JPH-Botron/WiegandEmulator/WiegandTestHolder.FCStd

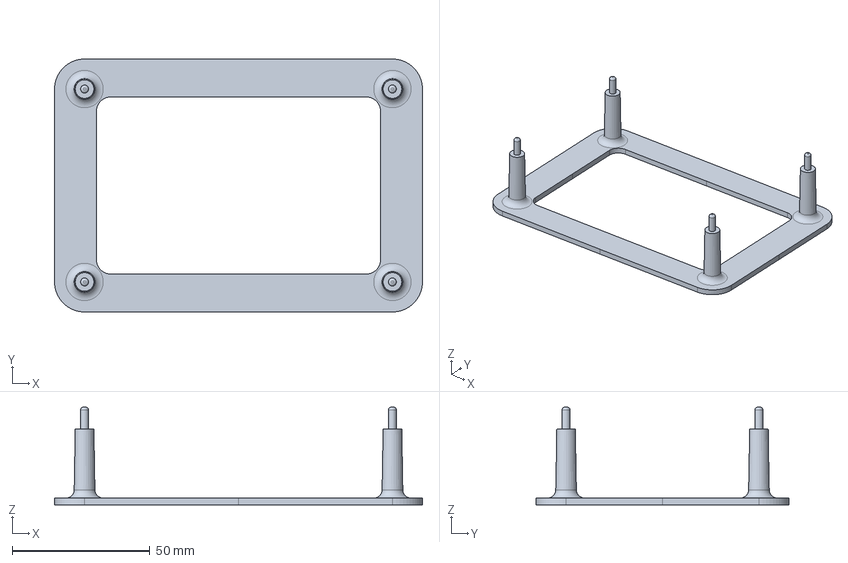
[picture p1: CAD file, 2025-12-03]
WiegandTestHolder.FCStd
133.6 x 91.8 x 35.5 mm
