JPH-Botron/WiegandEmulator/WiegandTest.step

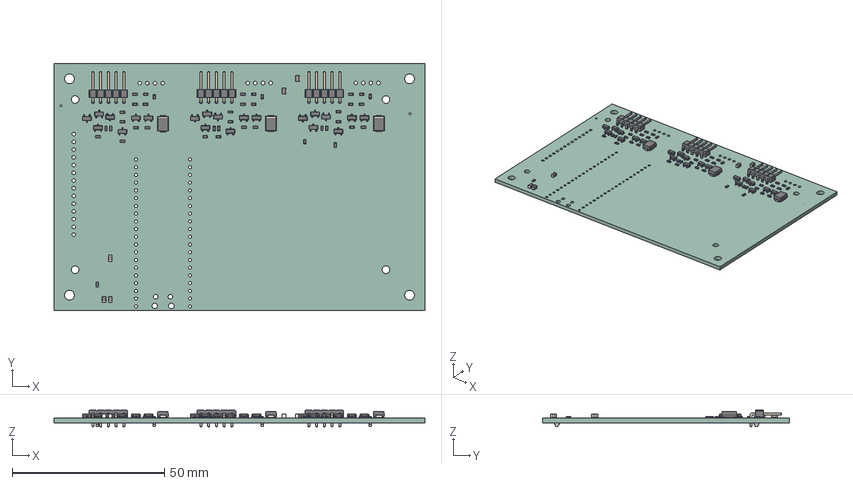
[picture p2: CAD file, 2025-12-03]
WiegandTest.step
121.9 x 81.3 x 5.54 mm
SOT_23 x 21
R_0603_1608Metric x 40
C_0805_2012Metric x 5
PinHeader_1x05_P254mm_Horizontal x 3
D_SMB x 3
LED_0603_1608Metric x 4
WiegandTest_PCB
