JPH-Botron/WiegandEmulator/3D/1881464_00.stp

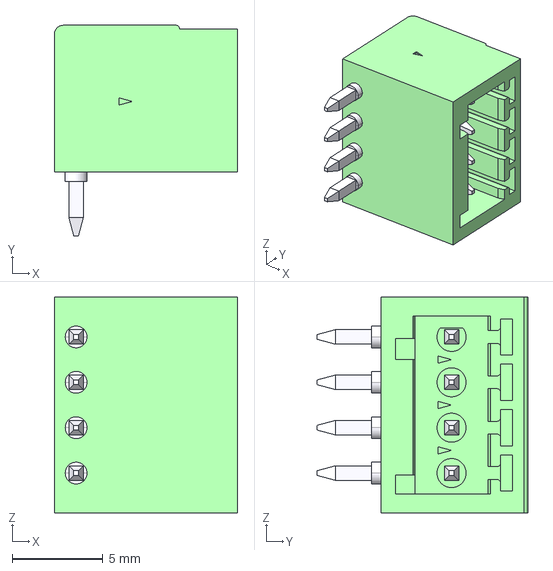
[picture p3: CAD file, 2025-11-04]
3D/1881464_00.stp
10.1 x 11.6 x 11.9 mm
