JPH-Botron/WiegandEmulator/(list of files, cad)

Other CAD files:
WiegandTestHolder-Body.step
