JPH-Botron/WiegandEmulator/(commit log)

2025-11-04 Initial Revision
    [1881464_00.stp, CPU.kiicad_sch.kicad_sch, Channels.kicad_sch, Interface.kicad_sch, WiegandTest.kicad_pcb, WiegandTest.kicad_sch]
2025-11-04 Mostly done. Still need to do connections to LCD; waiting to get an actual LCD to verify connector location on PCB part. May need to switch to 14 pin FFC, but hopefully not.
    [CPU.kiicad_sch.kicad_sch, Channels.kicad_sch, WiegandTest.kicad_pcb]
2025-11-07 OK, first basic layout complete - still need to do DRC and ERCs, get a good BOM going.
    [CPU.kiicad_sch.kicad_sch, Channels.kicad_sch, WiegandTest.kicad_pcb, WiegandTest.kicad_sch]
2025-11-10 No ERCs, No DRCs. Excluded silkscreen past edge of board violations, not worth the time to fix. Still need to complete BOM (MFG, MPN, on all parts)
    [CPU.kiicad_sch.kicad_sch, Channels.kicad_sch, WiegandTest.kicad_pcb, WiegandTest.kicad_sch]
2025-11-10 BOM in schematic now completed via Digikey. Board should be ready to build.
    [CPU.kiicad_sch.kicad_sch, Channels.kicad_sch, WiegandTest.kicad_sch]
2025-11-10 Minor additions of text on schematics.
    [CPU.kiicad_sch.kicad_sch, Channels.kicad_sch]
2025-11-10 BOM now has added JLCPCB data; gerbers and drill info created for JLC. This rev was ordered from JLCPCB on this day.
    [CPU.kiicad_sch.kicad_sch, Channels.kicad_sch, JLCWiegandTest.csv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]
2025-12-03 Created a board holder, started working on code. Created change list for next version of HW. Code now has one working state machine measuring transitions on Wiegand A receive pins. That's it so far.
    [WiegandTest.step, WiegandTestHolder-Body.step, WiegandTestHolder.FCStd]
2025-12-03 Due mostly yo yhe work of ChatGPT, this thing appears to be basically working on all three channels. Not using the display yet. Received message printed format not yet very good.
2025-12-05 OK, it all works, and the touch controller is up. It just outputs to the display (the position of the touch). I am calling this done, and I will likely turn off the touch functions shortly.
    [commands.cpp, commands.h, main.cpp, terminal.cpp, terminal.h, wiegand_port.cpp]
2025-12-08 Bit ordering was wrong in transmit and receive. Fixed that, and created the file bitorder.md to explain proper bit order.
    [bit_utils.cpp, bit_utils.h, commands.cpp, wiegand_port.cpp, wiegand_port.h, wiegand_rx_log.h]
2025-12-19 FW now has the ability to generate QR and Code128 barcodes on the display courtesy of GPT. About to start board update to Rev B that incorporates changes in wiring. Pretty happy with the whole thing 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
2025-12-19 OK, Schematic is good for Rev B. PCB not updated yet to match new schematic changes.
    [CPU.kiicad_sch.kicad_sch, Channels.kicad_sch, WiegandTest.kicad_sch]
2025-12-22 Fixed PCB. Added new rev info to schematics. No DRCs. Should be good to go at this time.
    [WiegandTest.kicad_pcb, WiegandTest.kicad_sch]
2026-01-20 Added bar code display to FW, moved CPU on PCA to be a right angle from the Wiegand outputs, fix a bunch of trace issues.
    [WiegandTest.kicad_pcb]
2026-03-23 This is Rev C, which is a smaller PCB where the LCD no longer fits on the board. Still has the LCCD connector, though.
    [CPU.kiicad_sch.kicad_sch, Channels.kicad_sch, WiegandTest.kicad_pcb, WiegandTest.kicad_sch]
2026-03-23 LCD connector was still on back; moved it to front.
    [CPU.kiicad_sch.kicad_sch, WiegandTest.kicad_pcb]
