JPH-Botron/WiegandEmulator/(notices)

Notices in the files:
WiegandTest.kicad_pcb:
Copyright 2026
